pit-true/GBAcapture/docs/recorder-esp32p4-status-20261018.md

# ESP32-P4 録画機ファームウェアの現状と課題(2026-10-18 中断時点)

ローカルの Qwen(dsh ハーネス + Strata)に実装させていた作業を、2026-10-18 20:43 に中断した。
この文書は、中断した時点のファームウェアの状態・課題・かかった時間をまとめたもの。

## 1. まとめ

- 受信・音声・SD 書き込み・PC からの読み出しは動く。未達は、映像を 60fps で録ること。
- 4 倍(960×640)で録ると、正しく測った値で毎秒約 20 フレーム。60fps には届かなかった。
- 10/18 に 2 倍(480×320)で録り、PC で 2 倍に拡大する方式へ切り替えた。コードは入れたが、録画はまだ一度も通っていない。(同日夜に 2 倍が通り、深夜に 4 倍 60fps も通った。9 章)
- 手作業待ちを除いてかかった時間は約 41.5 時間。そのうち Qwen が実際に作業していたのは 36.6 時間で、その 2 割(7.4 時間)は文脈の圧縮に使われた。

## 2. かかった時間

対象は qwen セッション `qwen-20261014-001503`(10/14 00:15 〜 10/18 20:43、全体 116.5 時間)。
セッション記録の各ターンの開始と終了の時刻から集計した。

| 区分 | 時間 |
|---|---|
| 全体 | 116.5 時間 |
| ユーザーの手作業待ち | 75.0 時間 |
| └ Qwen が操作を依頼して止まっていた間 | 37.3 時間 |
| └ 10/16 08:48 〜 10/17 22:28(LED と USB の確認待ち。USB をつなぎ直して再開) | 37.7 時間 |
| **手作業待ちを除いた時間** | **41.5 時間** |
| └ Qwen の作業時間 | 36.6 時間(うち文脈の圧縮 7.4 時間) |
| └ Windows Update による PC の再起動で止まっていた間(10/14 05:44 〜 09:03) | 3.3 時間 |
| └ その他の停止(ハーネスの立て直しなど) | 約 1.6 時間 |

- 夜間など、ユーザーが応答できない時間に操作を依頼して止まっていた分も、手作業待ちに含めた。
- 監督(Claude)が自分で調べたりバッチを作ったりした時間は、Qwen の作業と並行していたので別に数えていない。

## 3. 動いていること

| 項目 | 状態 | 根拠 |
|---|---|---|
| nano との USB-HS 接続 | 動く | 1209:c001 を列挙し、EP 84/81/83 から毎秒 4.96MB を受信。取りこぼし 0 |
| 映像フレームの組み立て | 動く | 毎秒約 60 フレーム組み立てられる(録画できる速さは別。5 章) |
| 音声 | 合格 | 20 秒の録画で AAC 985 フレーム、末尾 20.99 秒、取りこぼし 0(r105) |
| 時刻(PTS) | 修正済み | 535 秒になる不具合と、音声が倍速になる不具合は直した |
| microSD への書き込み | 動く | 新しい SanDisk 32GB(SDHC)。8MB 試験で毎秒 4.8MB、読み戻し一致 |
| PC から SD を読む(MSC) | 動いた実績あり | F: に見え、REC_0005 を取り出せた。戻すときに落ちる不具合も修正済み(build51) |
| H.264 ハードウェアエンコード | 動く | 録画しないベンチマークなら 4 倍で毎秒 61.4 フレーム |

## 4. 段階計画の到達点

| 段階 | 内容 | 状態 |
|---|---|---|
| A | 60fps で 20 秒録画(映像 1150 フレーム以上・音声約 940・末尾 pts 約 20 秒) | 未達。音声だけ合格 |
| B | MSC の往復(F: に最新 REC、戻してクラッシュなし、続けて録画) | 個別には動いた。最近の変更のあとで通しては試していない |
| C | GPIO2 のボタンで録画の開始と停止、GPIO3 の LED | コード(button.c)はある。実機では未確認 |
| D | 手順書 `docs/recorder-esp32p4-runbook.md` の更新 | 未着手。中身が 10/14 時点のまま(960×640 前提、ケーブル未確保など) |
| E | 完了報告 | 未着手 |

## 5. 映像が 60fps に届かない理由(4 倍のとき)

1 フレームの処理は、GBA の 240×160 を色変換して 4 倍に拡大し(YUV420 で 921,600 バイト)、ハードウェアエンコーダに渡す流れ。

| 計測 | 映像 | 備考 |
|---|---|---|
| 録画しないベンチマーク | 毎秒 61.4 フレーム | 拡大 14ms、エンコード 10ms |
| 録画(r108) | 663 フレーム / 33.4 秒 = 毎秒約 20 フレーム | 20 秒で止める合図が遅れ、33 秒回った |

録画中だけ遅くなる理由は 3 つ。

1. **外付けメモリ(PSRAM)の取り合い。** USB の受信、拡大結果の書き込み、エンコーダの読み込みが同時に PSRAM を使う。拡大のうち色変換は、ベンチマークの 6.9ms から録画中は 25.8ms まで延び、PSRAM への書き込み待ちも 18.9ms かかった。
2. **コア 0 の混雑。** USB ホストの処理が CPU の 22〜24% を使い、DMA の完了割り込みもコア 0 に来る。拡大の処理がそのたびに中断され、コア 0 が空かなくなって、見張り役(ウォッチドッグ)が警告を出す。
3. **内部 RAM の不足。** エンコーダは内部 RAM にひと続きの約 69KB を要る。DMA の作業領域などと取り合いになり、録画が始まらなかったり、SD への書き込みが「メモリ不足」で失敗したりした。

試して効かなかったこと: PPA(拡大がバイリニア補間になり、ドットが崩れる)、色変換の表引き(256KB 版も 1.5KB 版も録画中は速くならない)、DMA の同時発行を 2 から 4 に増やす。

## 6. 480×320 方式の現状(10/18 にユーザーが決定)

- 録画機は 480×320 で録り、PC で `recorder/tools/upscale_x2.bat` を使ってドットのまま 2 倍(960×640)にする。
- 480×320 なら、YUV420 の色 1 つがちょうど GBA の 1 ドットに当たるので、色がにじまない。データ量は 4 倍のときの 4 分の 1。
- コミット済み(7d60410): 既定値を 2 倍・8Mbps に変更。2 倍専用の拡大処理を追加。NVS に残っている 4 倍の設定を 2 倍へ移す処理も入れた。
- 未コミットの変更が `recorder/main/video_enc.c` に残っている。2 倍のときは DMA の作業領域を作らない変更。効果はまだ確かめていない。
- 録画はまだ通っていない。最後の試験(rec94)では、次の 2 点が起きた。
  - 起動直後の内部 RAM の空きは 429KB。エンコーダの起動時の準備で 264KB 減り、録画を始めた時点では 83KB しか残っていない。480×320 でこれほど使うのはおかしい。4 倍の大きさで確保しているか、エンコーダの部品が内部 RAM を使う作りになっている疑いがある。
  - 拡大の処理(scale_a)がコア 0 を独り占めしてウォッチドッグが出た。2 コアに分けた作りの残りで、2 倍のときは作られない相方を待ち続けている疑いがある。

## 7. 課題(優先順)

1. **480×320 で 20 秒の録画を通す。**
   - エンコーダの起動時の確保が 264KB になる原因を突き止め、480×320 の大きさにする。
   - 2 コアに分けた作りを外し、拡大は 1 本の処理に戻す。
   - 未コミットの `video_enc.c` の変更を確かめてコミットする。
2. 録画できた mp4 を `upscale_x2.bat` で変換し、ドットがそのまま並ぶか目で確かめる(バッチは試験用の動画でしか試していない)。
3. 段階 B〜D を進める。MSC の往復を通しで試す。ボタンと LED を実機で確かめる。手順書を 480×320 前提に書き直す。
4. 試験用に入れたものを片づける。
   - 調査用のコードを製品のファームから外すか、別ビルドに分ける。PPA の試験(`ppa_probe.c`)、SD の生セクタ試験、診断用の 1 文字コマンドがこれに当たる。
   - 試験用に入れた設定を戻す。ヒープポイズニングが一番重い設定(COMPREHENSIVE)のままで、メモリの確保と解放のたびに遅くなる。録画中の速さに響いている可能性もある。
   - コメントの日付が「2026-10-19」になっている(正しくは 10-18)。「監督指示」と書いたコメントも外す。
5. `recorder/tools/` は `.gitignore` の対象なので、`upscale_x2.bat` はリポジトリに入っていない。残すなら置き場所を変える。
6. 古い microSD は、書き込みが成功と返るのに内容が残らない故障品だった。捨てるか、使わない印を付ける。

## 8. 進みが遅かった理由

- Qwen の 1 ステップは 10〜60 秒かかり、1 つの手を入れて結果が出るまでに 20〜30 分かかった。
- 文脈の圧縮が 1 回約 9 分で、作業時間の 2 割を占めた。
- 調べ物に寄り道しがちで、監督が割り込みで方向を戻す場面が多かった(PPA の調べ物、ESP-IDF の内部コードの読み込み、ログの読み返しなど)。
- 監督(Claude)の判断ミスで回り道した分もある。FAT が壊れているという見立て(実際はカードの故障)、DMA 化(内部 RAM を食い、録画中は速くならなかった)、2 コアへの分割(途中で方式を変えた)。

## 9. 2026-10-18 夜の続き(Claude が実機で作業)

### 結果

- **480x320 の 20 秒録画が通った**(REC_0013: 映像 1211 枚 / 20.27 秒 = 59.7fps、音声 635 枚 / 20.29 秒、取りこぼし 0、ウォッチドッグなし)。
- mp4 を PC で検査: avc1 480x320、mp4a 32000Hz、映像と音声の長さが一致。`upscale_x2.bat` で 960x640 にしてドットがそのまま並ぶことを目で確認した。
- 2 倍ベンチ(nano 停止中): 拡大 5.0ms/枚(表引き 2.9 + 書き出し 2.1)、エンコード 3.0ms → 134.5fps。

### 遅かった本当の理由

- USB ホスト(HS の割り込み 1 万回/秒 + usbh タスク)が **core0 の 6〜7 割**を使う。同じ core0 に置いた拡大は 2.5 倍遅くなり(2 倍で 9.7ms → 24.8ms/枚)、core0 が 100% になって main も IDLE0 も止まっていた。5 章の「PSRAM の取り合い」は主因ではなかった。
- core1 では rx の復号(1 ライン 19us)と AAC(1 枚 11ms × 47 回/秒 ≒ core1 の半分)が重かった。

### 入れた対策

| 対策 | 効果 |
|---|---|
| nano のサンプル → (Y,U,V) の直引き表(96KB、internal)。rx は復号をやめて memcpy だけ | 拡大の rgb 7.0 → 2.9ms/枚、rx 20% → 8% |
| 拡大タスクを core1 の prio3 へ(core0 は USB だけ) | core0 の飽和が解消、main が毎秒回る |
| 2 倍でも PSRAM 書き出しを GDMA(段 11,520B × 4) | 拡大の CPU 2.6ms/枚ぶんを DMA へ |
| AAC を 48kHz → 32kHz(nano の実レート 32802Hz とほぼ 1:1) | AAC の仕事 2/3。音声の取りこぼし 0 |
| USB 受信リングの起こし方を 1ms まとめ読みに(毎パケットのコア間割り込みをやめた) | rx 16% → 8% |
| ヒープポイズニング(COMPREHENSIVE)を無効化 | 試験用設定の撤去 |
| 2 コア分割の残骸を削除、日付と「監督指示」の表記を修正 | 整理 |

録画中の CPU(2026-10-18 t5): core0 = usbh 39% + IDLE0 57%、core1 = scale 28% + aac 22% + rx 8% + mux 3% + enc 2% + IDLE1 34%。

### 新しく入れた道具

- `recorder/scripts/p4pull.py` + コンソール `D`: いちばん新しい mp4 を UART(1.5Mbps)で PC へ出す。MSC はケーブルの差し替えが要るので、手を借りずに確かめる道。
- `recorder/scripts/upscale_x2.bat`(tools/ から移動。リポジトリに入った)。

### 気づいたこと

- **COM6 を開くと基板が再起動する**(CH343 の DTR/RTS)。手順書に書いた。
- Git Bash から ESP-IDF を使うときは `MSYSTEM` を消してから export する。
- REC_0013 は画面全体が左へ 14 ドット回り込んでいた(左端に縦の筋、左の 14 ドットは右端の絵)。次の REC_0014 は正常。nano の列位相(不変条件 V4)が 1 回ずれたと見ている。ビューアでも起きるか要確認。

### 残り(優先順)

1. LED の実機確認(ボタンは 10/18 深夜に確認済み)
2. MSC の往復を最新ビルドで確認(段階 B)。ケーブルの差し替えが要る
3. 30 分連続録画と発熱、スライス境界の IDR
4. 試験用コードの整理(`ppa_probe.c`、SD 診断コマンド)
5. 列位相ずれの再現条件

### nano FW v0.34(2026-10-18 深夜、ユーザーの指示で実施)

ユーザーが nano を PC につなぎ直したので、nano の FW を v0.34 にした。全パケットを 484B から 512B
(中身 484B + 詰め 28B)にして、ショートパケットをなくした。ESP32-P4 のホストは 4KB の転送 1 本で
8 パケットをまとめて受け取れるので、転送完了の処理が 1/8 になる見込み。
PC 側の CLI・ビューア・録画機のパーサも 512B に合わせた。PC での再検証(freq、framestat、capture、
streamtest、ビューアの目視)は不変条件の文書に追記した。

録画機側も実機で確かめた(t10〜t13)。

| 試験 | 結果 |
|---|---|
| 2 倍 20 秒(512B パケット、EP4 を 4KB 転送) | usbh が core0 の 39% → 12%。IDLE0 84% |
| 同上の 1 回目 | 1 枚あたり 3.3 ラインが欠けた。EP4 を 8 パケットまとめて受けるので、EP1 で先に届いたフレーム N+1 のラインが、EP4 にまだ残っていた N の末尾より先に見え、N を途中で閉じていた |
| 対策 | frame_pipe を 4 枠にして N と N+1 を同時に組む。EP1 は 512B、EP3 は 1KB の転送に戻す。欠けは 0 になった |
| 4 倍 20 秒(拡大 1 本、core0) | 1233 枚 / 21.4 秒 = 57.5fps。拡大 16.6ms/枚で core0 を使い切り、main が遅れた |
| 4 倍 20 秒(拡大を上下 2 コアに分割) | **1210 枚 / 20.27 秒 = 59.7fps、欠け 0、音声 635 枚 / 20.29 秒**。IDLE0 42%、IDLE1 27% |

4 倍の mp4(REC_0018)を PC で見て、960x640 でドットが正しく、上下の継ぎ目(320 行目)にも乱れがないことを確かめた。
既定の倍率を 4(16Mbps)にした。2 倍に戻すにはコンソールの `2`。

### 960x640 を基板で直接録ることについて(10/18 夜の時点の見立て。上記のとおり同日深夜に達成)

CPU の総量で見ると、USB ホスト 65% + 拡大(4 倍で約 8ms × 60 = 48%)+ AAC 33% + rx 8% + mux/enc 5% ≒ 160%(2 コアで 200%)で数字の上では入るが、USB は core0 から動かせず、core0 に拡大を同居させると 2.5 倍遅くなる実測がある。PSRAM の流量も 4 倍になる。現実的には **nano 側で 1 ラインを 512 バイト詰め(484 + 詰め物)にして USB の転送回数を 1/10 以下にする**変更が先で、それで core0 が空けば 960x640 を試す価値がある。nano の FW は今は触らない方針なので、480x320 + PC で 2 倍を本線とする。
