pit-true/GBAcapture/docs/roadmap.md

# ロードマップ / 将来計画

## 現行フェーズ: 映像取得（専用ソフトで見えれば良い）

docs/architecture.md のマイルストーン M0〜M5 を参照。

## 将来計画（ユーザー指定のメモ）

1. **音声のデジタル取得**
   - GBA の音声をデジタル段階で取り込む（今は保留中）
   - 映像と同一 USB ストリームに多重化してリップシンク確保が目標
2. **UVC 化**
   - USB Video Class 対応にして OBS 等の標準ソフトでそのまま使えるように
   - 音声は UAC (USB Audio Class) との複合デバイス化を検討
3. **録画デバイスの作成**
   - PC レスで録画できるスタンドアロン機器へ発展

## その他の改善候補（開発中に追記）

- LDR1/LDR2 の配線を PB6/PB7 へ移設し全 15bit を単一 DMA で取得（docs/wiring.md）
- NRST/BOOT の外部制御による完全ハード無人化（docs/flashing.md）
- GitHub リポジトリ公開（必要になったら）
