pit-true/GBAcapture/docs/gba-video-signal.md

# GBA LCD 映像信号仕様

GBA 本体→LCD のパラレル信号をタップして取り込む（いわゆる偽トロ方式）。
2026-07-05 に文献調査で検証済み（✅）。実機実測で最終確認したら「実測✅」に更新すること。

## タイミング（文献検証済み）

| 項目 | 値 | 検証 |
|---|---|---|
| ドットクロック (DCK) | 4.194304 MHz (= 16.777216 MHz ÷ 4) | ✅ GBATEK |
| 1ライン | 308 ドット周期（可視 240 + H-Blank 68）、~13.620 kHz | ✅ GBATEK |
| 1フレーム | 228 ライン（可視 160 + V-Blank 68） | ✅ GBATEK |
| フレームレート | 4194304 ÷ (308×228) = **59.7275 Hz** | ✅ GBATEK / SPS実測59.728Hz |

## ⚠️ 最重要: DCK はバーストクロック

**DCK は可視ピクセル区間のみ 240 パルス出る**（ブランキング中は停止）。連続 4.19 MHz ではない。
→ フリーランサンプリング不可。**DCK エッジ同期トリガ（タイマ入力キャプチャ→DMA）が必須**。
→ 逆に言えば DCK パルス数 = 有効ピクセル数なので、ラインバッファは 240 サンプルでちょうど埋まる。

## 信号詳細（squk/GBA-LCD リバエン資料より）

| 信号 | 意味 | タイミング |
|---|---|---|
| DCK (DCLK) | ピクセルクロック | **データは負エッジ（立ち下がり）で有効/ラッチ** ✅ |
| LP | ラインラッチ（水平同期相当） | 正エッジアクティブ ✅ |
| SPS | ゲートドライバスタート（垂直同期相当） | **負エッジアクティブ**。負エッジ間隔 16.743ms ✅ |
| LDR1-5 / LDG1-5 / LDB1-5 | RGB 各5bit パラレル (15bit) | ✅ |
| SPL / CLS / PS | 未配線（SPL=HSYNC系正エッジ, CLS=ゲートクロック, PS=VBLANK中デューティ変化） | 参考 |

- フレーム先頭は「SPS パルス → SPL パルス」のシーケンスでマークされる
- LDx1 が LSB か MSB かは**未確定（実キャプチャの階調で確認する）**

## データ量

- 1ピクセル 15bit → 16bit 格納で 2 byte。1ライン 480 byte、1フレーム 76,800 byte
- 転送レート ≈ 4.59 MB/s ≈ 36.7 Mbps → USB-HS バルクで十分

## 出典

- GBATEK LCD Dimensions and Timings: https://problemkaputt.de/gbatek-lcd-dimensions-and-timings.htm
- squk/GBA-LCD (信号リバエン): https://github.com/squk/GBA-LCD
- insideGadgets 実測記事: https://www.insidegadgets.com/2019/08/08/playing-around-with-the-gba-lcd/

## 実機実測結果（2026-07-05、M1完了）

1. ✅ **DCK = 240パルス/可視ライン**（DCK/SPL比 = 241±1 で確認）
2. ✅ **LP/SPL比 = 1.425 = 228/160** → LP は全228ライン、タップした PA2 の信号は
   **SPS ではなく SPL（可視ライン開始、160回/フレーム）**だった。
   SPL は VBLANK 中に約5ms の休止ギャップがあり、「ギャップ後の最初のパルス=ライン0」
   でフレーム同期できる（FW v0.15 で実装、キャプチャ成功）
3. ✅ **LDx1 = LSB 確定**（実キャプチャ画像の色が正しいことで確認）
4. ✅ DCK 負エッジでの入力キャプチャ+DMA 取得でクリーンな画像が得られた
5. ⚠️ 残課題: FWの1秒計測窓が約15%長い（全計測値が一律1.15倍。相対値は正確）。
   SysTick換算(Ticks_from_Ms)の要調査。実周波数はDCK=229万/s等の理論値で正しい
