pit-true/GBAcapture/capture03.bmp

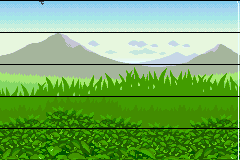
capture03.bmp
