pit-true/GBAcapture/capture04.bmp

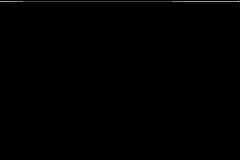
capture04.bmp
