pit-true/GBAcapture/capture06.bmp

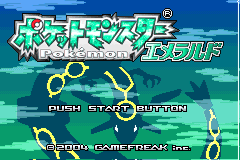
capture06.bmp
