pit-true/GBAcapture/capture06_hen.png

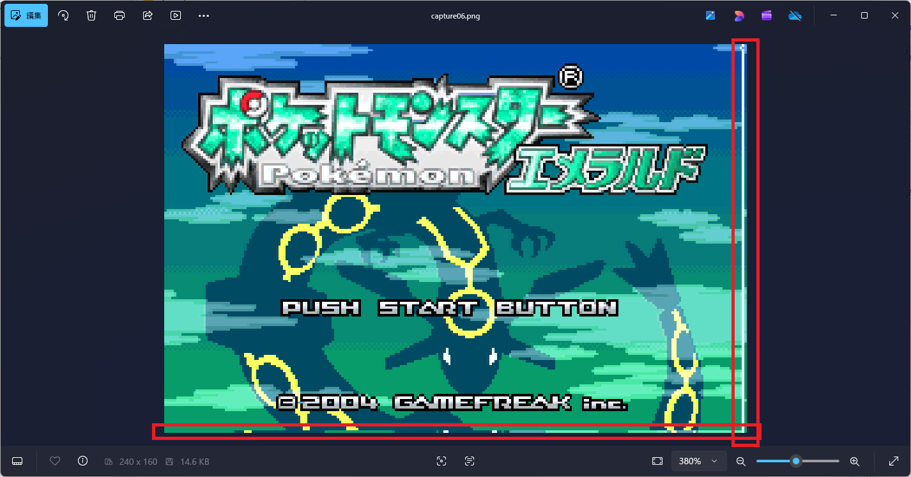
capture06_hen.png
