pit-true/GBAcapture/capture07.bmp

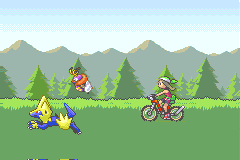
capture07.bmp
