pit-true/GBAcapture/capture07_hen.png

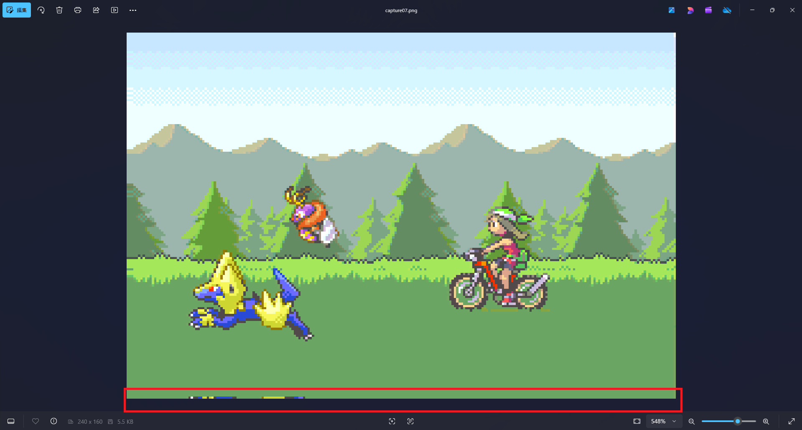
capture07_hen.png
