pit-true/GBAcapture/capture08.bmp

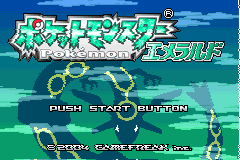
capture08.bmp
