pit-true/GBAcapture/capture09.bmp

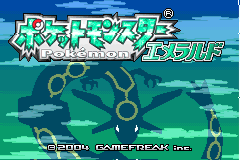
capture09.bmp
