pit-true/GBAcapture/docs/captures/midare.png

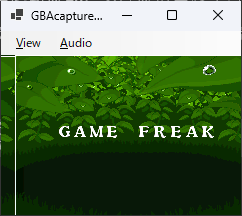
docs/captures/midare.png
