pit-true/GBAcapture/docs/photos/nanoCH32C305.jpg

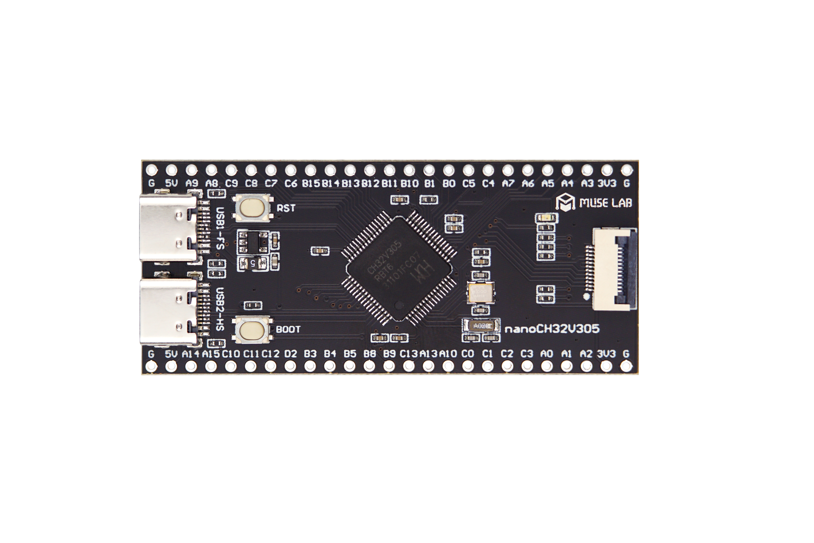
docs/photos/nanoCH32C305.jpg
