pit-true/GBAcapture/docs/photos/配線図.jpg

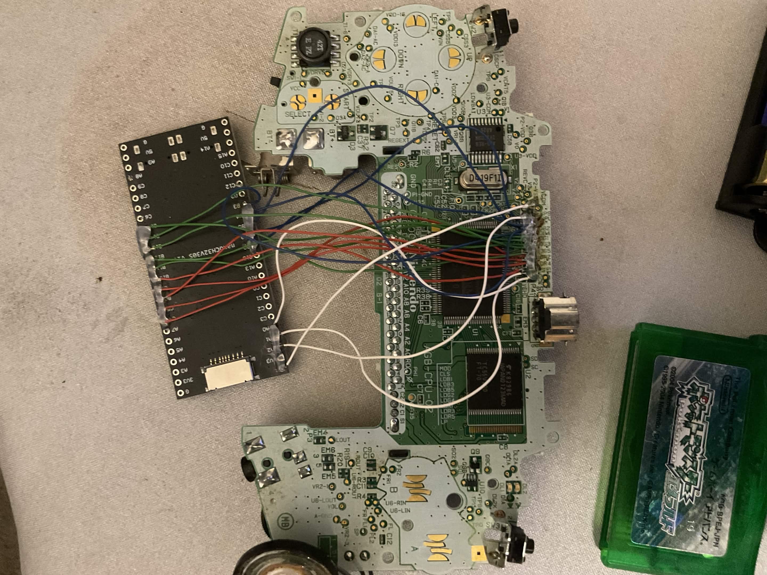
docs/photos/配線図.jpg
