pit-true/GBAcapture/eizou_hen02.png

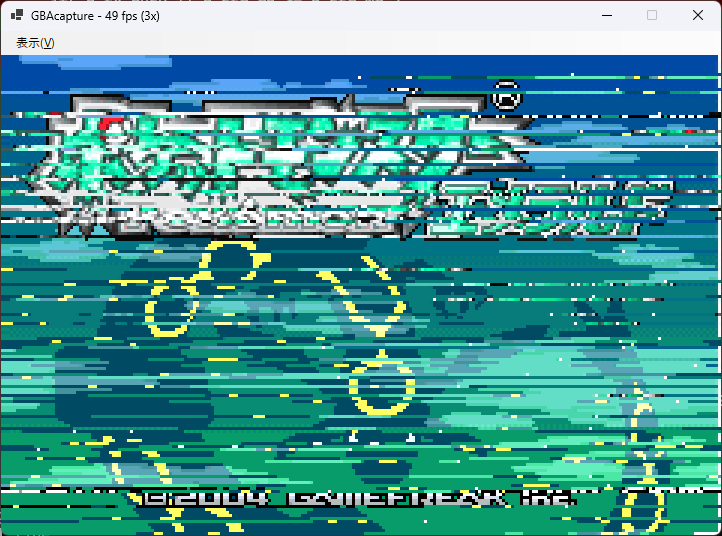
eizou_hen02.png
