pit-true/GBAcapture/eizou_hen03.png

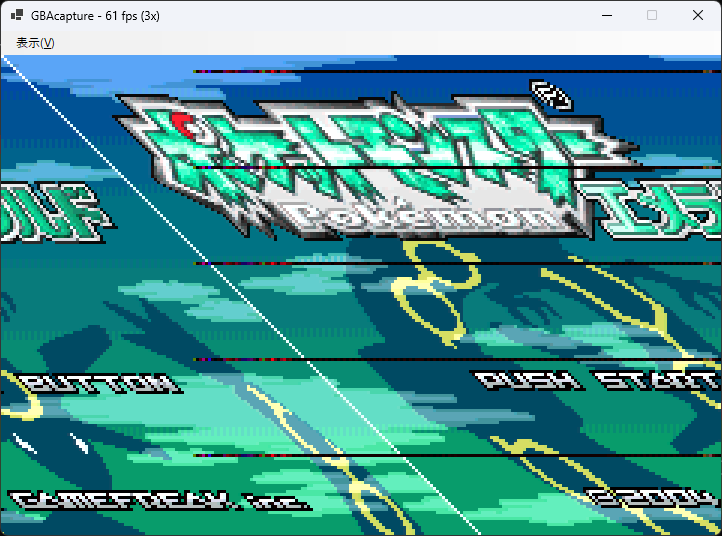
eizou_hen03.png
