pit-true/GBAcapture/eizou_hen04.png

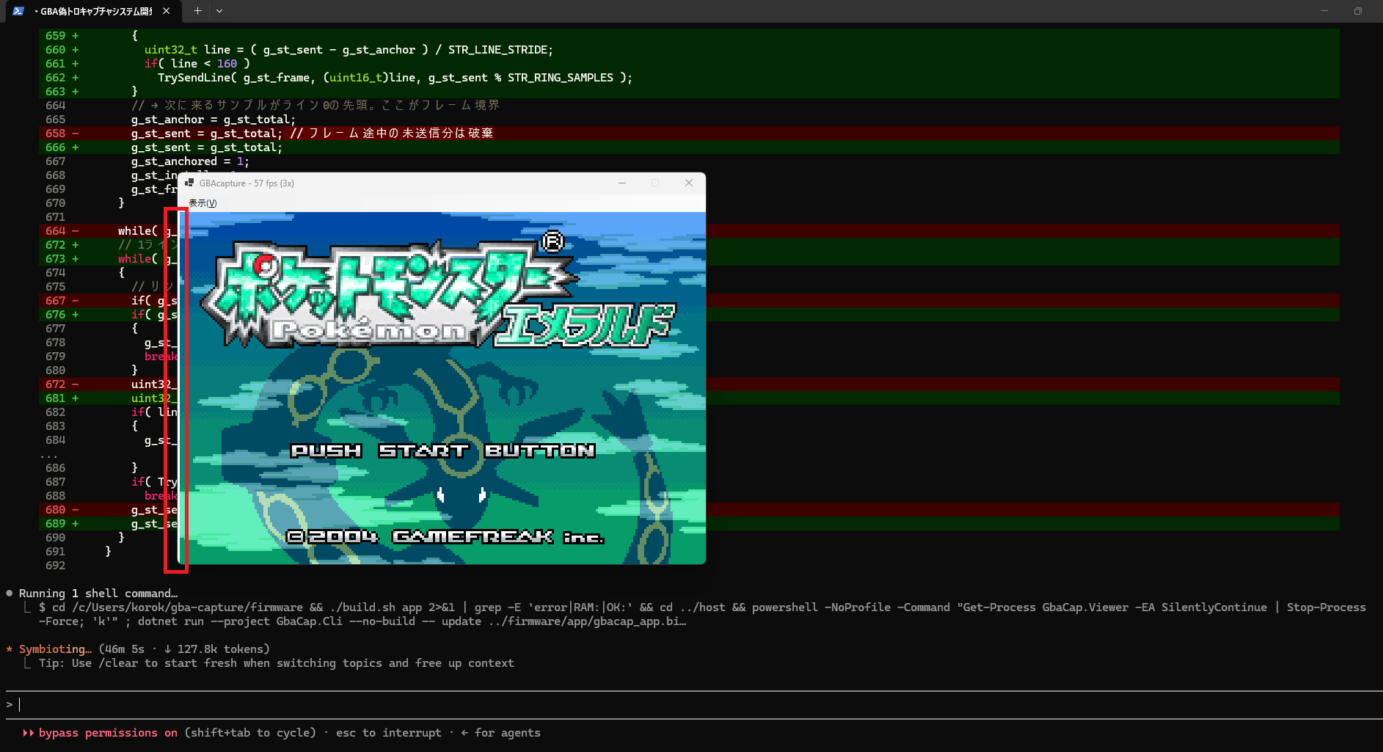
eizou_hen04.png
