pit-true/GBAcapture/eizou_hen.png

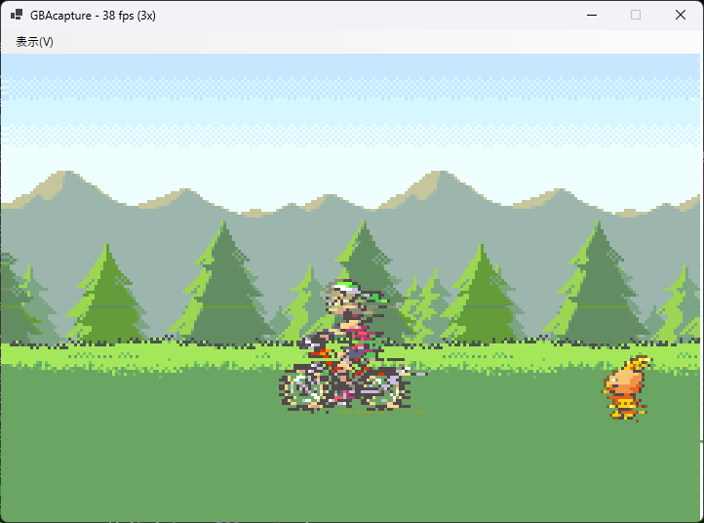
eizou_hen.png
