pit-true/GBAcapture/docs/wiring.md

# 配線表（GBA ↔ nanoCH32V305）

**nano側のピン割り当てはこの表が正（マスター）**。記載順は「GBA側 - nanoCH32V305側」。

> ⚠️ 2026-07-05 更新: 実機診断により **GBA側のタップ位置が映像信号ピンとずれている**ことが
> 判明（本ページ末尾の診断結果参照）。ユーザーのGBAは**40ピンコネクタの初期型**。
> 検証済みの正しいピン配置と付け替え先は **[gba-40pin-pinout.md](gba-40pin-pinout.md)** を参照。
> nano側の割り当て（この表）は変更しない。

## 制御・電源系

| GBA側 | nanoCH32V305側 | 役割 |
|---|---|---|
| **P1-GND**（基板シルク印字のビア） | G (GND) | グラウンド共通化（2026-07-05 付け替え） |
| DCK | PA0 | ドットクロック（ピクセルサンプリングのトリガ） |
| LP | PA1 | ラインパルス（水平同期） |
| SPS | PA2 | フレーム開始（垂直同期） |
| — | PA3 | LED（nano側デバッグ用。GBAとは未接続） |

> ⚠️ 教訓: 当初 GND は「P2-VSS」ビアに接続していたが、**P2-VSS は40ピン機の
> 液晶パネル電源系ネットでありロジックGNDではない**。共通GND欠如により全信号が
> 浮いて定常HIGHに見える障害となった（ADC実測でnanoの3.3Vレール張り付きを確認）。
> GBA側のGNDは P1-GND / BT- / カートスロットシールド等の確実な0Vを使うこと。
> なお信号タップはGBA基板のシルク印字ビア（LDB1等）で正しい。

## RGB データ (15bit パラレル)

| GBA側 | nanoCH32V305側 | | GBA側 | nanoCH32V305側 | | GBA側 | nanoCH32V305側 |
|---|---|---|---|---|---|---|---|
| LDR1 | **PC4** | | LDG1 | PB11 | | LDB1 | PB9 |
| LDR2 | **PC5** | | LDG2 | PB12 | | LDB2 | PB8 |
| LDR3 | PB0 | | LDG3 | PB13 | | LDB3 | PB5 |
| LDR4 | PB1 | | LDG4 | PB14 | | LDB4 | PB4 |
| LDR5 | PB10 | | LDG5 | PB15 | | LDB5 | PB3 |

> ⚠️ **要確認**: LDx1 が LSB か MSB か（GBATEK 等の信号名は LD_R0..R4）。
> 実キャプチャ画像の階調を見て確定させ、ここに追記する。

## GPIOB 入力レジスタ (INDR) のビット割り当て

DMA で `GPIOB->INDR` を 16bit 一括読みしたときの各ビットの意味:

| bit | 15 | 14 | 13 | 12 | 11 | 10 | 9 | 8 | 7 | 6 | 5 | 4 | 3 | 2 | 1 | 0 |
|---|---|---|---|---|---|---|---|---|---|---|---|---|---|---|---|---|
| 信号 | G5 | G4 | G3 | G2 | G1 | R5 | B1 | B2 | — | — | B3 | B4 | B5 | — | R4 | R3 |

`GPIOC->INDR` 側: bit4 = R1, bit5 = R2。

## R1/R2 がポートCにある件（配線での解決は不可能と確認済み）

回路図 (`tools/nanoCH32V305/hardware/nanoCH32V305.pdf`) を確認した結果:

- **PB6/PB7 は USB2(HS) の D-/D+ 専用**（LQFP64 ピン58/59、J1コネクタ直結）→ GPIO として使用不可
- **PB2(BOOT1) はヘッダに出ていない**（10kΩで GND に接続、基板内のみ）
- ヘッダに出ている GPIOB は PB0,PB1,PB3-5,PB8-15 の13本のみ = すべて使用済み

つまり**全15bitを単一ポートに集約するのは物理的に不可能**。ユーザーもこれを理由に現配線とした。

対応方針:
1. **フェーズ1**: GPIOB のみ13bit（赤3bit階調）で映像を出す
2. **フェーズ2**: GPIOC (PC4/PC5) を第2の DMA チャネルで並行取得して15bit化。
   同一 DCK エッジから2つの DMA 要求を作る方法（PA0 = TIM2_CH1/ETR と TIM5_CH1 の
   二重割り当て等）は M2 で実機検証する

## ボード実測情報（回路図で確認済み）

- オンボード LED: **D1(青) = PA3** ✅（配線表と一致、FWから直接制御可）
- USB1 (J3) = Full-Speed (PA11/PA12)、**USB2 (J1) = High-Speed (PB6/PB7)** ← キャプチャは USB2 側を使う
- BOOT0: S2ボタン(押下で3V3)、10kΩプルダウン / NRST: S1ボタン
- **ISPブートローダ突入手順（board README）: BOOTを押したまま → RSTを押して離す → BOOTを離す**

## ⚠️ 実機診断の結果（2026-07-05、FW v0.11 の rawdiag/プルテストによる）

GBA電源ON状態での計測:

| 事実 | 解釈 |
|---|---|
| GBA OFF→全ピンLOW / ON→全ピンHIGH | 配線はGBAの電源ドメインに導通している |
| DCK/LP/SPS/RGB全13bitが**定常HIGH**でエッジ皆無 | **映像信号が来ていない** |
| 内部プルダウンで引いても落ちない | 浮きではなく外部から強く駆動されている静的な線 |
| **PB12 (LDG2) のみプルダウンで落ちる** | **この1本だけ浮いている（ハンダ不良疑い）** |

→ タップ先が LCD 映像信号線ではない可能性が高い。**要ハードウェア確認**:
1. GBA本体の画面にゲーム映像が出ているか（出ていれば信号はコネクタに存在する）
2. **GBAのLCDコネクタが32ピンか40ピンか**（初期型は40ピンで、ピン配置が32ピンと
   異なる。参照した偽トロ配線資料がどちら前提だったか要照合）
3. タップ箇所の再確認（全信号が定常HIGH = 電源系/バイアス系/未使用ピンに乗っている可能性）
4. PB12(LDG2) のハンダ再確認

## 変更履歴

- 2026-07-05: 初版（ユーザー申告の配線を記録）
- 2026-07-05: 回路図確認により配線最終確定。PB6/PB7転用不可のためDMA 2ch方針に変更
