pit-true/GBAcapture/(commit log)

2026-07-05 プロジェクト初期化: ドキュメント・スキル・デコードTDD第1サイクル
2026-07-05 調査反映・環境構築・M0ビルド成功・ホスト側TDD3サイクル完了
2026-07-05 hooks提案をsetup.mdに記録
2026-07-05 ホスト側をC#/.NET 8へ全面移行・配線最終確定を反映
    - host/: GbaCap(コアライブラリ) + GbaCap.Tests(xUnit 14件 green)。Python版は削除
    - 回路図確認: PB6/PB7はUSB2(HS)専用でGPIO転用不可 → 全15bit単一ポート集約は物理的に不可能
    - 配線は最終確定(変更禁止)。15bit化はGPIOC第2DMAチャネル方針に変更
    - LED=PA3(D1青)確定、ISP突入手順(BOOT押したまま→RST押して離す)を記録
2026-07-05 M0実機書き込み成功を記録（Zadig/WinUSB割当→wchisp flash→自動リセット確認）
2026-07-05 M0.5: USB-HSデバイスFW + C#製CLI（ping/enter-bootloader）実装
    - firmware/m05-usb: VID 1209:C001 バルクデバイス。EP5(OUT)コマンド受信、
    EP4(IN)応答。GBAC+B でMODEフラグ+ソフトリセットによるISP突入
    - host/GbaCap.Cli: LibUsbDotNet 3.0.224 + libusb-1.0(x64同梱)
    - コマンドはバルクOUT経由（ch32funスタックにベンダーリクエストフックが無いため）
2026-07-05 FW v0.6: ブートローダ突入診断コマンド追加 + スタックDMAバグ回避
    - ch32fun USBHS_SendEndpoint のdataポインタが常にUEP2_TX_DMAへ書かれる
    バグ([2-1]ハードコード)を確認 → EP4既定バッファへのmemcpyで回避
    - 診断: 'S'(MODEKEYRのみ)/'T'(KEYRアンロック込み)でMODEフラグの
    セット可否をSTATR読み戻しで確認できる。'P'は前回リセット要因も返す
    - 'B'/'C' 突入変種、CLI に cmd/test-bootloader/enter-bootloader-c 追加
    - test-bootloader でBコマンドによるリセット発生自体は確認済み
    （課題はブートローダがMODE突入を弾くことのみ）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
2026-07-05 FW v0.7: M1信号計測を先行実装（TIM2外部クロックでDCK、EXTIでLP/SPS計数）
    - 'F'コマンドで1秒窓の DCK/LP/SPS カウントを20B応答で返す
    - CLI に freq コマンド追加
    - MODEフラグ方式の不成立を docs/flashing.md に記録（RM V1.5にMODEビット無し、
    実機診断でもSTATR読み戻し0）。代替方式は調査中
2026-07-05 FW v0.7: ブートローダ突入を直接ジャンプ方式に確定（ROM逆アセンブルに基づく）
    V30x BTVER2.9 ROMは入口チェック無し。全IRQ無効化+ペンディングクリア、
    SysTick停止、USB完全停止の後 0x1FFF8000 へジャンプ。
    MODEフラグ方式の残骸(S/T/C)は削除
2026-07-05 ソフトISP突入は実機検証で不成立と確定、IAP方式への転換を設計
    - 直接ジャンプ: USB切断・リセットは起きるがISPは一度も列挙されず、
    アプリが数秒で正常復帰（ROMがBOOT0=0マッピングで動作不能。リマップ機構無し）
    - IAP設計: 16KB IAP @0x08000000 + APP @0x08004000、マジック+ソフトリセットで
    IAP滞留→USB経由更新。wchispは救済用に
2026-07-05 M0.6: IAP方式の手放し書き込みループ実装
    - firmware/iap: 16KB @0x08000000。BKPマジック判定→APP起動 or USB更新モード
    (消去/256Bチャンク書込/加算チェックサム検証/再起動)
    - firmware/app: 旧m05-usbを0x08004000へ再リンク。'U'コマンドでIAPへ遷移
    - firmware/make_full.sh: 初回・救済用の統合イメージ生成
    - CLI: update コマンド (APP→IAP遷移→消去→書込→検証→再起動→版数確認まで全自動)
    - flash スキルを手放しフロー主体に書き換え
2026-07-05 手放し書き込みループ完成を実証 (APP v0.8→v0.9をボタン操作なしで更新)
    - CLI Reopen: 例外時にデバイスハンドルを解放しないと以降のopenが失敗するバグを修正
    - 実証済みフロー: APP('U')→BKPマジック+リセット→IAP更新モード→消去→書込→
    チェックサム検証→'G'→新APP起動。所要約10秒、物理操作ゼロ
2026-07-05 CLAUDE.md: 手放しループ実証済みに更新
2026-07-05 ボタンフリー手順書(hands-free-loop.md) + 生ピン診断コマンド'R'/rawdiag追加 (v0.10)
    診断結果: 全信号ピンが完全に0 → GBA電源断の疑い。
    初回計測の約60Hzはノイズだった可能性が高い
2026-07-05 v0.11: プルテストで配線問題を特定（全信号線が静的HIGH駆動、PB12のみ浮き）
2026-07-05 M2: キャプチャパイプライン実装 (FW v0.12 'L' + CLI capture + BmpWriter TDD)
    - FW: SPS待ち→LP毎にDCK負エッジ入力キャプチャ+DMAでGPIOB 240サンプル/ライン取得、
    484Bラインパケットで送出。EP4送信を専用512Bバッファに一新
    - CLI: capture <out.bmp> — 32ライン×5回で全160ライン→RGB888→BMP保存
    - BmpWriter: 24bit BMP エンコーダ (TDD、テスト17件 green)
    - 実機: エラー経路確認済み (信号なし→status=2 を正しく報告)
2026-07-05 40ピンLCDコネクタの検証済みピン配置を文書化（原因=タップ位置ずれ）
    任天堂サービスマニュアル回路図(squk/GBA-LCD収録)由来、gbaHDと17信号一致。
    向き判定手順(GND導通の位置)と付け替え先一覧、検証コマンドを記載
2026-07-05 v0.13: rawdiagにGPIOC(PC4/5)とGPIOBビット別エッジ数を追加。GND未接続仮説を提起
    全18信号線が定常HIGH + DCK/LP/SPSが同期して~60Hzブリップ
    → 共通GND欠如による浮遊電位の挙動と一致
2026-07-05 v0.14: ADC電圧計測(volt)で GND未接続を確定。IWDGハング自動復旧を追加
    - 全ピンがnano自身の3.3Vレールに張り付き(GBAロジック2.9Vではない)
    = 保護ダイオードクランプ → 共通GND欠如の決定的証拠
    - ch32funのfunAnalogReadはV30xでSWSTARTトリガ未設定により無限ループするため
    自前ADC実装(タイムアウト付き)に差し替え
    - IWDG 6.5秒でメインループハングから自動復旧(ボタン不要化)
    - 対処: GND線をBT-(電池マイナス)へ付け替え1箇所のみ。信号線18本は正しい見込み
2026-07-05 配線変更を記録: GNDをP2-VSS→P1-GNDへ付け替え（P2-VSSはパネル電源系でロジックGNDでない）
2026-07-05 🎉 初キャプチャ成功 (v0.15): エメラルドタイトル画面の取得に成功
    - 根本原因はGND (P2-VSS≠ロジックGND) → P1-GND付け替えで全18信号が復活
    - PA2の実信号はSPSでなくSPL(可視ライン開始×160/フレーム)と判明
    → VBLANKギャップ検出によるフレーム同期に変更
    - 実測確定: DCK=240/ライン, LP=228/フレーム, LDx1=LSB
    - docs/captures/2026-07-05_first-light.png 収蔵、READMEに掲載
2026-07-05 v0.16: 静止画キャプチャの品質問題を全て解消 + 赤下位2bit取得
    - 黒線5本: ラインパケットをUSB送信バッファに直接組み立てていたため
    送信中に上書きされ全パケット1本ズレ → ステージングバッファ経由に修正
    - 前回実行の残骸212Bがパイプに残る問題 → 開始時drain+マジック再同期
    - 白縦線/行ズレ: SPLアーム時に先頭約2DCKを取り逃す構造
    → ホスト側 SampleOffset=2 補正
    - 赤下位2bit: TIM2 CC2(TI1写像)→DMA1_CH7でGPIOC並行取得、パケットv2(724B)
    - テスト19件 green。capture07: 欠落0・全エッジ正常・15bitフルカラー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
2026-07-05 v0.17: ストリーミングFW('S'/'X')実装 + 最終行調査(DMA全転送完了・境界重複なし=実出力の疑い)
2026-07-05 v0.20: サーキュラDMA+VBLANKアンカー方式で60fpsリアルタイムビューア完成
    - 水平ジッタ根治: ライン毎のIRQ再アームを廃止。DMAはサーキュラ(32ライン)を
    開始時1回だけアーム。DCKが可視区間しか動かない性質を利用し、
    VBLANK(約5ms)のDMA停止をメインループで検出→そこがライン0先頭(算術で確定)
    - 帯域: 1EP実効~3.3MB/s(NAK後の再ポーリングがマイクロフレーム単位)と判明
    → EP4/EP1/EP3の3本に分散し6.9MB/s(60fps)を確保
    - ラインパケットv3: 赤下位2bitをbit2/6に合成し484B/ライン(帯域半減)
    - ビューア: 3EP受信スレッド、ピクセルパ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
2026-07-05 v0.21: ラインストライド241修正(対角線ノイズ/画面ラップ解消) + ハード/音声計画doc
    - 実測でDCKは241パルス/ライン周期(可視240+H-blankジャンク1)。
    v0.20の対角線アーティファクトと以前の白縦線の真因
    - docs/hardware-adapter-plan.md: 32/40ピン両対応基板化の3段階プラン
    - docs/audio-plan.md: LOUT/ROUT→PA4/PA5、ADC+DMA+USB多重化方針
2026-07-05 CLAUDE.md: 状態を60fps達成時点に整理
2026-07-05 v0.22: 左端白線修正(ジャンクはライン先頭側→+1オフセット) + ビューアUI改善
    - 角丸無効化 (DWMWA_WINDOW_CORNER_PREFERENCE=DONOTROUND) で映像四隅の欠け解消
    - 8x → フルスクリーン(アスペクト比3:2維持レターボックス、Escで復帰)
2026-07-05 公開ポリシー整備: 第三者資料・ゲーム画面・作業用画像を追跡解除しローカル限定に
    - docs/publishing-policy.md: 公開前の履歴浄化手順(filter-repo or 新規リポジトリ)を明記
    - ビューア: スクリーンショット保存(F12/メニュー)、□ボタン=1x、
    上端スナップ=フルスクリーン、EnterFullscreenの最大化状態からの遷移修正
2026-07-06 音声タップ先を訂正: SO1/SO2(プリボリューム)を使用、LOUT/ROUTはアンプ出力のため不可
    スキャン拡大確認: LOUT/ROUTはP3(ジャック)隣=アンプ出力で音量連動。
    SO1/SO2がCPU音声出力(音量ホイール上流)。SO1→PA4, SO2→PA5。
    あわせてFW v0.23(LED常時消灯)をビルド済み(書き込みはUSB復帰待ち)
2026-07-06 M6: 音声ストリーミング実装 (SO1/SO2 → 48kHz PCM → ビューアで再生)
    - FW v0.24: TIM3 TRGO 96kHzトリガのADCスキャン(IN4/IN5)+DMA1_CH1サーキュラ取得、
    2サンプル平均で48kHz化(簡易ローパス)、音声パケット0xA6(484B)を映像と同じ
    EP群に多重化。v0.23のLED常時消灯も同梱
    - ビューア: NAudio(WasapiOut 120ms)で再生、DCオフセット自動除去、
    メニュー「音声」にミュートとL/R入替
    - 音声はGBA音量ホイールと無関係に取得(SO1/SO2=プリボリューム)
2026-07-06 音声ノイズ対策 + 音量コントロール
    - FW v0.25: 192kHzサンプリング+4サンプル箱型平均で48kHz化(PWMキャリア減衰)、
    ch4/5のADCサンプル時間を13.5cycに短縮(オーバーラン余裕確保)
    - ビューア: 2次バターワースLPF 15kHz、音量25/50/75/100%プリセット+スライダー
    (既定50%)
2026-07-06 ビューア: スケール切替時のToolStripSeparatorキャスト例外を修正
2026-07-06 v0.26: 音声ノイズ根治 — PWMキャリア同期積分方式
    GBATEKで確認: GBAのPWMキャリアはSOUNDBIAS設定によらず32.768kHzの整数倍。
    262.144kHz(=32.768k×8)でサンプリングし、キャリア1周期=8サンプルの箱型平均で
    32.768kHz出力 → フィルタ零点が全キャリア高調波に一致し原理的にPWMノイズ消滅。
    従来の192k→48k変換ではキャリアが15.2kHzに折り返して可聴ノイズ化していた。
    ホスト側はWDLリサンプラで32.768k→48kHz変換、LPFも32.768kHz用に再設計
2026-07-06 v0.27: 音割れ修正 — 音声パケットの順序破壊を根治
    原因: 音声を3本のEPにラウンドロビン送信していたため、ホストの3受信スレッド間で
    パケット順序が入れ替わり音声が時間シャッフルされていた(音割れ/ノイズの主犯)。
    音声はEP3専用(単一EP=順序保証)、映像はEP4/EP1の2本(4.6MB/s<6.6MB/s)に変更
2026-07-06 v0.28: 音声524kHz/16点積分に増強 + ホスト入力レートをFW実レート(32727Hz)に一致
2026-07-06 v0.29: 安全強化(IWDG先行開始/ADCキャリブレーションタイムアウト) + 327.68kHz/10点積分
    - v0.28の523.6kHz/1.5cycサンプリングはADC変換時間がぎりぎりで
    取りこぼしのリスクがあったため、余裕のある10点/周期(13.5cyc)に変更
    - ビューアにデバッグ録音(生サンプルWAV保存、GBACAP_AUDIODUMPで自動)を追加
    - HDMI基板の写真確認: 市販品もSO1/SO2直後にRLC+オペアンプのフィルタを実装
    = アナログフィルタ必須の裏付け
2026-07-07 音声RCフィルタ(1kΩ+10nF)実装を記録、v0.29書き込み完了
2026-07-07 音声基準ゲインを1/8に調整 (100%で常識的な音量に)
2026-07-07 偽ころキャプチャに改名 (v0.30) + LEDキャプチャ中のみ点灯 + NO SIGNALオーバーレイ
    - USB製品名: NisekoroCapture (VID/PID不変なのでドライバ影響なし)
    - LED(PA3): ストリーミング中かつGBA信号が生きている(SPL 100ms以内)ときのみ点灯
    - ビューア: 1.5秒フレームが来ないと映像上に NO SIGNAL を表示
2026-07-07 GBAcapture (Nisekoro-capture): ビューアUI英語化 + README英語再構成 + L/R判定用GBAテストROM
    - ビューア: メニュー/ステータスを英語化 (View/Audio/Fullscreen/Mute/Swap L/R/Volume...)
    - README: 英語メイン(特徴/仕組み/構成/導入/ロードマップ) + 日本語docs索引
    - firmware/gba-pantest: 左=低音+赤画面/右=高音+青画面を繰り返す1KBのROM (devkitARMでビルド)
2026-07-07 L/R確定: pantest実測でSO1=右/SO2=左 → デフォルトマッピング修正
2026-07-07 L/R確定に伴いSwap L/Rメニューを削除
2026-07-07 仕様説明書(specification.md)と録画デバイス要件案(recorder-plan.md)を追加
2026-07-07 ビューアUX改善4点
    - 既定音声デバイスの変更に追従 (IMMNotificationClient監視+デバウンス300msでWasapiOut再生成)
    - ウィンドウを端にドラッグスナップ→フルスクリーン (WM_ENTER/EXITSIZEMOVEでドラッグ由来を判別、
    □ボタンクリックは従来通り1x)
    - フルスクリーン中に上部48pxをつまんでドラッグ→前回スケールに戻して掴んだまま移動継続
    - スケール/音量を %AppData%\GBAcapture\viewer.json に保存。初回既定は1x、以降は前回値を復元
2026-07-07 表示崩れ/スナップ不動作の修正 + 音声デバイス即時追従 + Debug Recordメニュー削除
    - 根因: ドラッグのモーダルループ内で同期的にウィンドウスタイルを変更していた
    → フルスクリーン切替等はBeginInvokeでループ脱出後に実行
    - ドラッグ終了時に上端(y<=6)で離したらフルスクリーン、それ以外はApplyClientSizeで
    サイズ自己修復(スナップ等で崩れても次のドラッグで直る)
    - 音声: 通知コールバック(50msデバウンス) + 500msポーリング照合のフォールバックで
    既定出力デバイス変更に即時追従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
2026-07-07 v0.31-33: 映像の巻き取りズレ根治 — フレームは実は161バースト(ダミーライン+可視160)
    - 'Q'/framestat診断でフレームあたり+241サンプル(=1バースト余分)が毎フレーム
    安定して存在することを実測 → VBLANK中のダミーラインバースト(SPLなし)と特定
    - ストールアンカーはダミーを「ライン0」と誤認し全体が1ライン+αズレていた
    - 修正: フレーム先頭SPLのリング位置から「本物のライン0」を特定し、アンカーを
    241の整数倍だけ前進補正(列位相はストールアンカーのサンプル精度を維持)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
2026-07-07 確定ロジック文書(capture-logic-invariants.md)を追加 + Mute/Volume排他動作
    - 映像/音声の不変条件20項目と検証コマンドを文書化、CLAUDE.md絶対ルール0に昇格
    - Mute ON→Volumeチェック解除 / Volume操作→Mute解除して発音
2026-07-07 README日本語化 + 最終品質スクショ(final-quality.png)採用
2026-07-07 README: 初キャプチャ記念スクショ復活+完成形(エメラルドタイトル)追加、非公開運用方針を明記
2026-07-07 録画デバイス要件確定(Pi Zero 2 W構成)+仕様書にFW/ホスト処理ロジック詳解を追加
2026-07-07 録画デバイス計画改訂2: mp4のみ・モバイルバッテリー給電・Wi-Fiなし、ボード候補比較を追記
2026-07-07 録画デバイス: タカチSW-125ケース設計とパネル部品(秋月Type-C取付キット等)を追記
2026-07-10 録画デバイス改訂3: ボードをRadxa Zero 3W(RK3566)に再選定（Pi Zero 2W在庫切れ・Type-C対応）
2026-07-10 録画デバイス改訂4: Radxa撤回(世界的品薄)、Pi Zero 2 Wフリマ調達方針+2026-07在庫調査を記録
2026-07-15 docs/project-status.md 追加: プロジェクト現状サマリ（新セッションの読み込み起点）
2026-10-14 ESP32-P4録画FWの全ソースとビルド設定の追加
2026-10-14 ボタン配線と使い方のdocs追加、gbacap部品のCMakeLists漏れ修正
2026-10-14 ビルド失敗3点の修正とESP-IDF環境のdocs追加
2026-10-14 ESP32-P4 rev v1.3向けリビジョン設定とAACコーデックの2.5系固定
2026-10-14 チップリビジョン表示の修正と起動時のヒープログ追加
2026-10-14 Kconfigの配置場所をmainへ移してエンコーダ単体ベンチを追加
2026-10-14 ESP32-P4-Picoの書き込み復旧手順と起動ログ取得ツールを追加
2026-10-14 最小起動確認モードと書き込みから起動ログ取得までの一括手順を追加
2026-10-14 PowerShellのBOM問題とSDKCONFIG既定の落とし穴を記録
2026-10-14 H264出力バッファのキャッシュライン整列を128バイトに広げ根拠をコメント化
2026-10-14 esp_h264のキャッシュライン制約とPSRAM対応をソースから確認し記録
2026-10-14 SD空き容量の監視と録画自動停止を追加
2026-10-14 mp4スライス切り替え直後のIDR強制の追加
2026-10-14 電源の抜き差しで起動ログを取る手順とp4watch.pyの追加
2026-10-14 実機でアプリが起動している初観測の記録
2026-10-14 コンソール受信経由の再起動・ベンチ・録画操作の追加
2026-10-14 コンソール1文字コマンドの説明とp4cmd.pyの追加
2026-10-14 電源断で未クローズのmp4が失われる注意とコンソール操作の追記
2026-10-14 mp4を箱単位で検査するスクリプトの追加と書き込み待機の進捗ログ改善
2026-10-14 開発ステップの状況表とpts単位の実証方針の追記
2026-10-14 ベンチ終了の検知と録画停止の順序修正でmuxタスクのハング対策
2026-10-14 実解像度の拡大検査とpts換算の単体テスト追加と通し手順の文書作成
2026-10-14 HWエンコーダの公称値とFAT32制限の出典を手順文書に追記
2026-10-14 エンコードスタック増量とパイプテストコマンド追加
2026-10-14 SD 結線総当たりとスロット 0 判定の追加
2026-10-14 書き込みモード再起動コマンドと自動書き込みスクリプトの追加
2026-10-15 ESP32-P4 書き込み手順の全自動化を実機で確定した docs 改訂
2026-10-15 4倍スケールの割り算廃止と32bitパック化による高速化
2026-10-15 SDカードのMBRとGPTを読む診断とスケール内訳計測の追加
2026-10-15 USBホストのポート状態レジスタを読む診断コマンドの追加
2026-10-15 PTS の後戻り拒否と録画停止ログの拡充
2026-10-15 音声入力の每秒計測と seq 飛び幅カウントの追加
2026-10-15 PC に SD を見せる MSC 切り替えとホスト後始末を追加
2026-10-15 ホスト後始末でEPをhalt→flushしURBを回収して畳む
2026-10-15 MSC解除でPHYを返すesp_tinyusb修正と往復のガード追加
2026-10-15 MSC中にSDの再初期化と速度テストを断るガード追加
2026-10-17 MSC解除の順序をuninstall先に変更
2026-10-17 SDマウント再試行追加
2026-10-17 停止ログにスケール内訳追加
2026-10-17 scale=4 OUYY 拡大の専用経路と参照実装テスト追加
2026-10-17 エンコードを拡大と 2 段パイプライン化
2026-10-17 mux の書き込み失敗で録画を止め SD 直接検査を追加
2026-10-18 SD を FAT32 で作り直す F コマンドと FatFs を内部 RAM 化
2026-10-18 SD 書き込み消失の切り分け検査を追加
2026-10-18 フォーマット後のジオメトリ表示を追加
2026-10-18 PPA SRM 実機プローブの追加
2026-10-18 拡大の PSRAM 書き出しを GDMA 化
2026-10-18 エンコーダと GDMA の internal RAM を起動直後に 1 回だけ確保
2026-10-18 internal RAM 差分表の追加と frame_pipe バッファの PSRAM 化
2026-10-18 タスク配置を core0=scale、core1=enc/aac/mux/rx へ変更
2026-10-18 DMA 同時発行を 4 へ増やし段バッファを 5 個化
2026-10-18 録画を 480x320 の 2 倍既定へ変更し 2 倍専用経路と設定移行を追加
2026-10-18 拡大をサンプル直引き表に変更し core1 へ移動
2026-10-18 USB 受信リングの起こし方を 1ms まとめ読みに変更
2026-10-18 AAC を 32kHz に変更
2026-10-18 最新 mp4 を UART で送る D コマンド追加
2026-10-18 ヒープポイズニング無効化
2026-10-18 コメントの日付と監督指示表記を修正
2026-10-18 録画機の手順書と状態文書を 10/18 の結果で更新
2026-10-18 パケットを 512B 詰めに変更 v0.34
2026-10-18 framestat の Q 応答をストリームから探すように修正
2026-10-18 録画機を 512B パケットと 4KB 転送に対応
2026-10-18 倍率を切り替える 2/4 コマンド追加
2026-10-18 パケット 512B 化を不変条件と仕様書と手順書に反映
2026-10-18 frame_pipe を 4 枠にして N と N+1 を同時に組む
2026-10-18 EP1 と EP3 の転送を小さく戻す
2026-10-18 4 倍の拡大を上下 2 コアに分割
2026-10-18 既定の倍率を 4 に変更
2026-10-18 4 倍 60fps の到達を状態文書と手順書に反映
2026-10-18 録画の最初の欠けた枠を捨て枠を黒で初期化
2026-10-18 ボタンの実機確認を文書に反映
2026-10-18 ボタン長押しと押しながら起動で MSC モードに入る
